impulseGomel/Simplex8/Si8_view.jpg

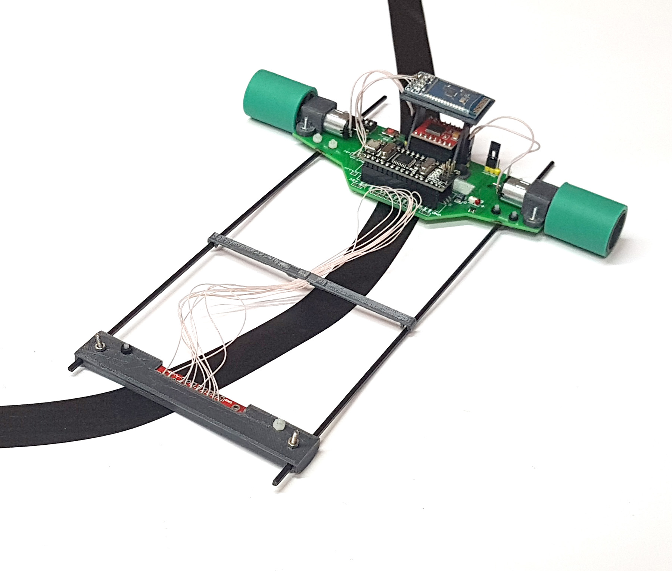
Si8_view.jpg
