impulseGomel/Simplex8/README.md

# Simplex8
Line Follower Robot based on Arduino nano
