impulseGomel/Simplex8/code/readme.txt

Simplex8_BT_v1.ino - пример релейного и пропорционального алгоритмов, запуск кнопкой или по bluetooth. Остановка по bluetooth.
