impulseGomel/Simplex8/Schematic_Simplex8_LFR.pdf

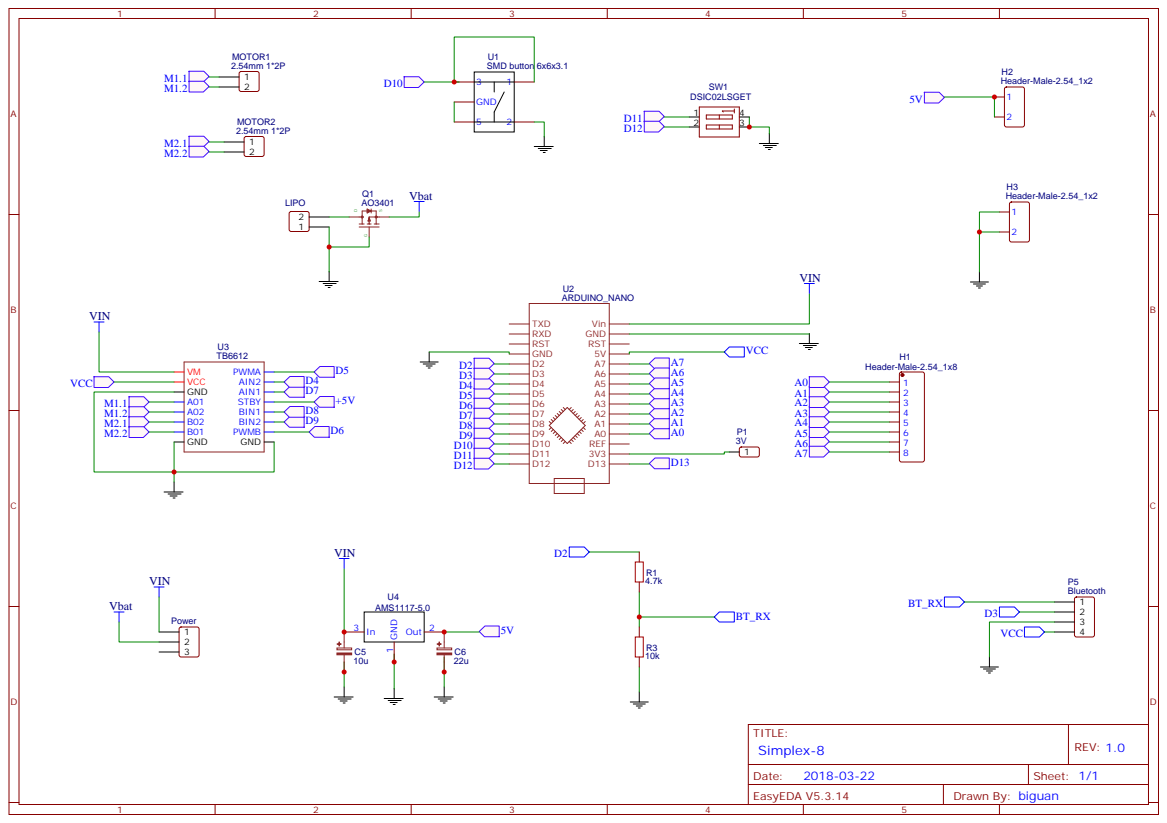
[picture p18: page 1]
